robzach/cakeCity/frostingExtruderBlockDiagram.png

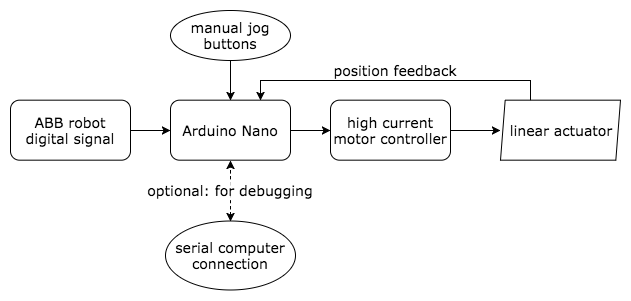
frostingExtruderBlockDiagram.png
