robzach/cakeCity/RobotPlateDesigns/robotPlateNEW.SLDASM

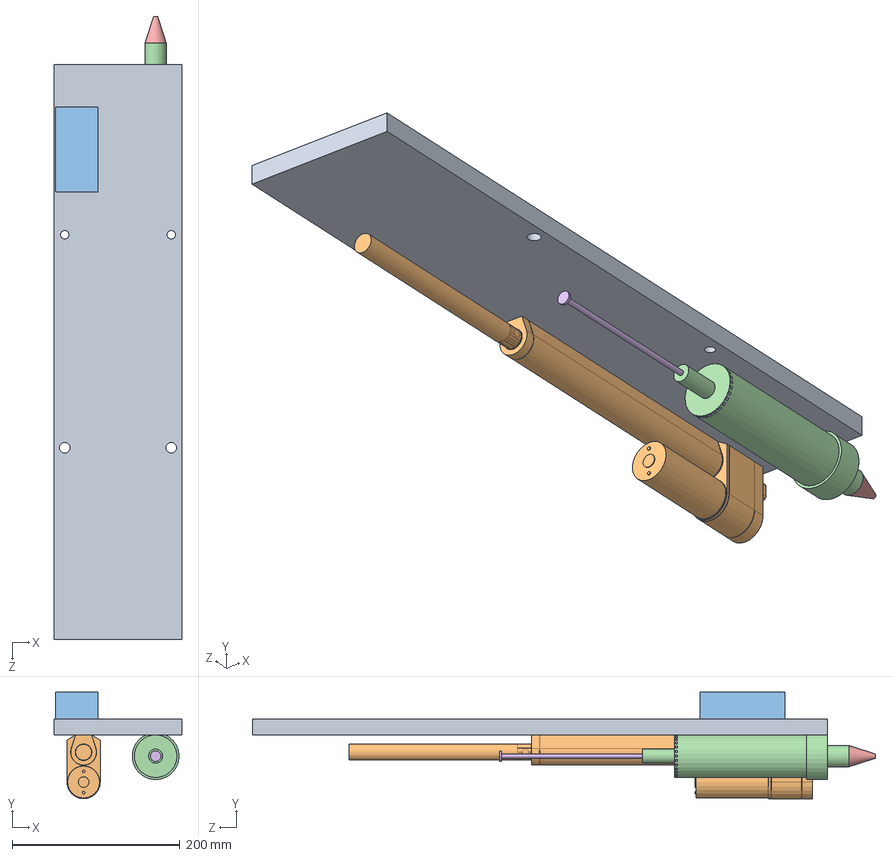
[picture p2: CAD file, 2017-04-19]
RobotPlateDesigns/robotPlateNEW.SLDASM
152.4 x 127.0 x 742.8 mm
backingPlate
linearActuator
PowerSupply
icingExtruderBody
icingTip
icingPlunger
