robzach/cakeCity/RobotPlateDesigns/robotPlate.SLDASM

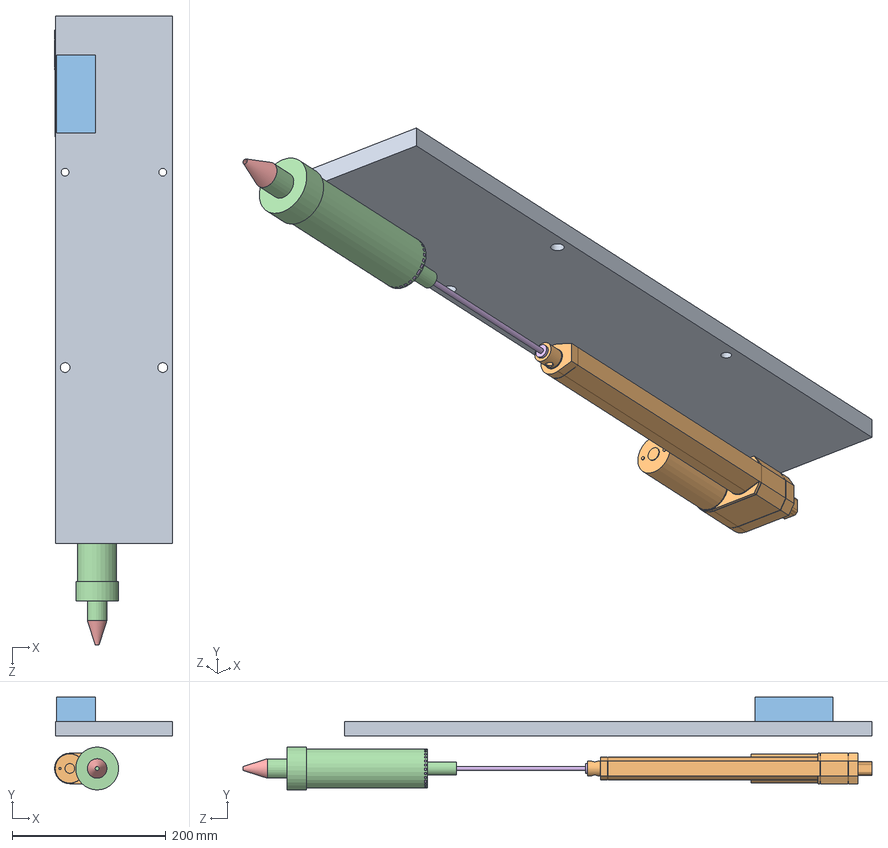
[picture p3: CAD file, 2017-04-19]
RobotPlateDesigns/robotPlate.SLDASM
153.5 x 120.9 x 818.1 mm
backingPlate
linearActuator
PowerSupply
icingExtruderBody
icingTip
icingPlunger
