robzach/cakeCity/RobotPlateDesigns/icingExtruder2.SLDASM

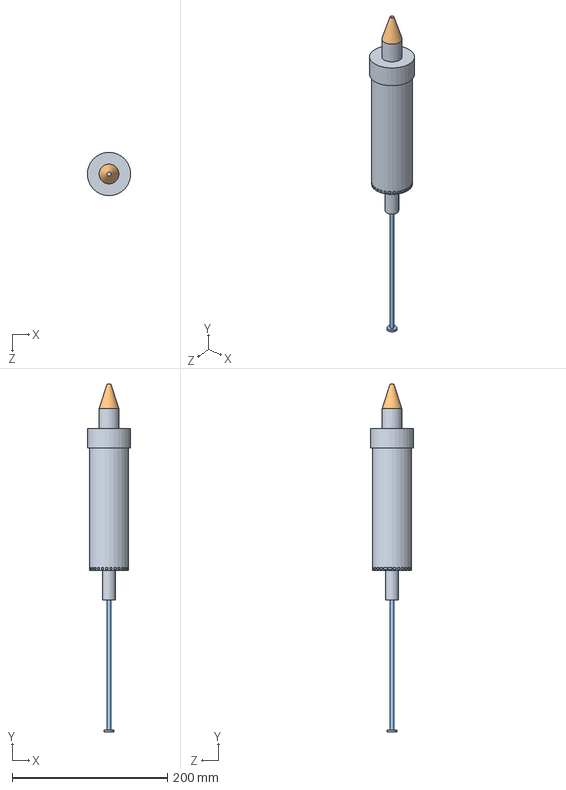
[picture p4: CAD file, 2017-04-19]
RobotPlateDesigns/icingExtruder2.SLDASM
55.6 x 448.2 x 55.9 mm
icingExtruderBody
icingTip
icingPlunger
