robzach/cakeCity/RobotPlateDesigns/linear_actuator_body_support.dxf

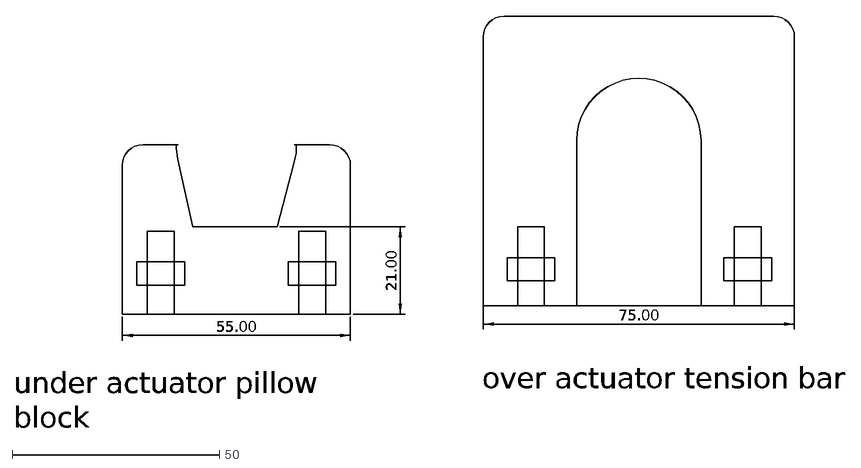
[picture p5: CAD file, 2017-05-11]
RobotPlateDesigns/linear_actuator_body_support.dxf
21.00
55.00
under actuator pillow block
75.00
over actuator tension bar
