robzach/cakeCity/RobotPlateDesigns/icing_press_support.dxf

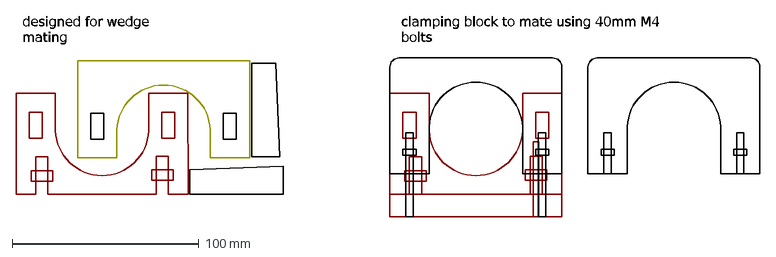
[picture p6: CAD file, 2017-05-11]
RobotPlateDesigns/icing_press_support.dxf
designed for wedge mating
clamping block to mate using 40mm M4 bolts
