robzach/cakeCity/RobotPlateDesigns/jog_button_mounting_plate.dxf

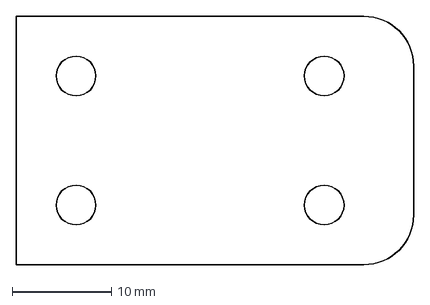
[picture p7: CAD file, 2017-05-10]
RobotPlateDesigns/jog_button_mounting_plate.dxf
40.0 x 25.0 mm
