robzach/cakeCity/RobotPlateDesigns/work_stand.dxf

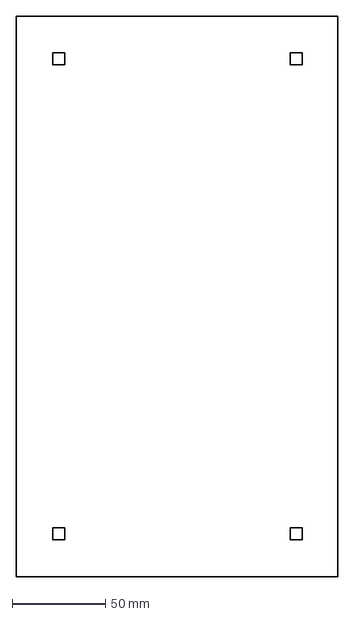
[picture p8: CAD file, 2017-04-26]
RobotPlateDesigns/work_stand.dxf
172.0 x 300.0 mm
