robzach/cakeCity/RobotPlateDesigns/backingPlate.SLDPRT

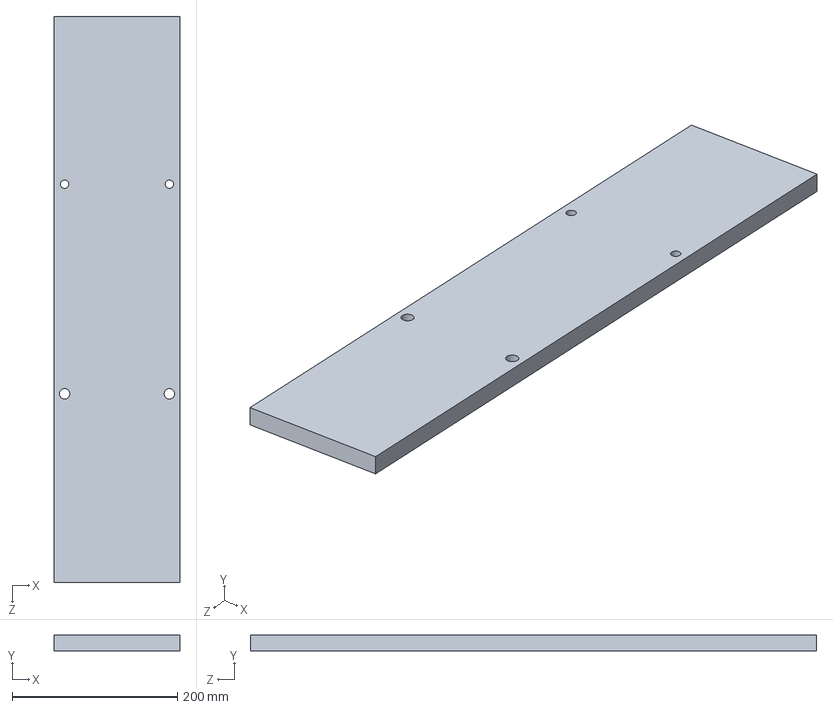
[picture p9: CAD file, 2017-04-19]
RobotPlateDesigns/backingPlate.SLDPRT
152.4 x 19.1 x 685.8 mm
