robzach/cakeCity/RobotPlateDesigns/linearActuator.SLDPRT

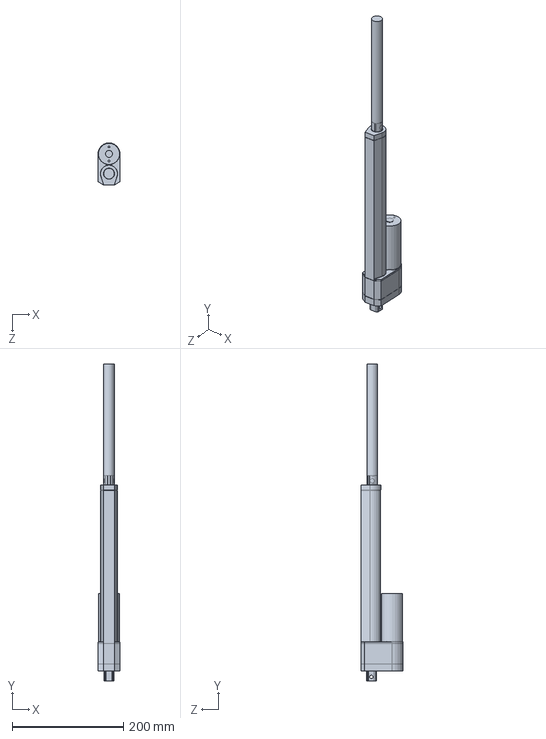
[picture p10: CAD file, 2017-04-19]
RobotPlateDesigns/linearActuator.SLDPRT
39.9 x 570.7 x 76.2 mm
