robzach/cakeCity/RobotPlateDesigns/icingPlunger.SLDPRT

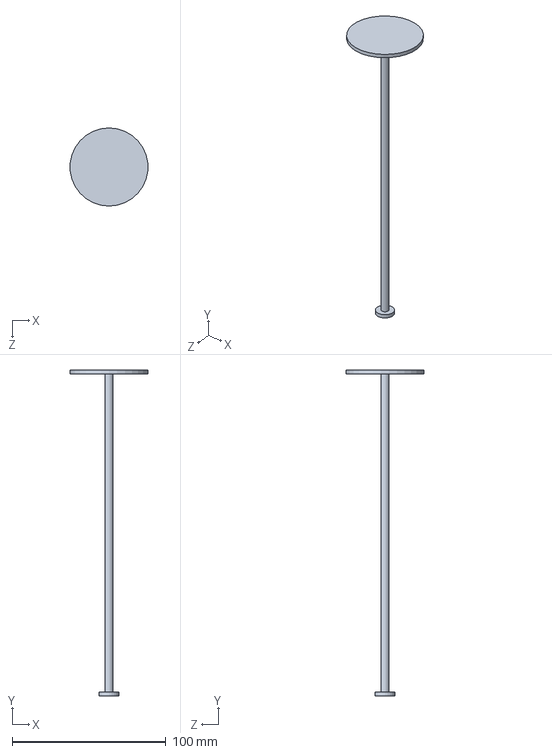
[picture p11: CAD file, 2017-04-19]
RobotPlateDesigns/icingPlunger.SLDPRT
50.5 x 212.1 x 50.8 mm
