robzach/cakeCity/RobotPlateDesigns/icingExtruderBody.SLDPRT

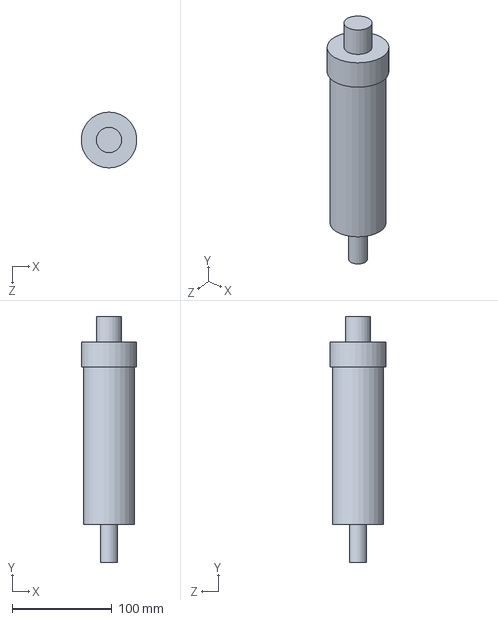
[picture p12: CAD file, 2017-04-19]
RobotPlateDesigns/icingExtruderBody.SLDPRT
55.6 x 246.4 x 55.9 mm
