robzach/cakeCity/RobotPlateDesigns/actuator_end_support.dxf

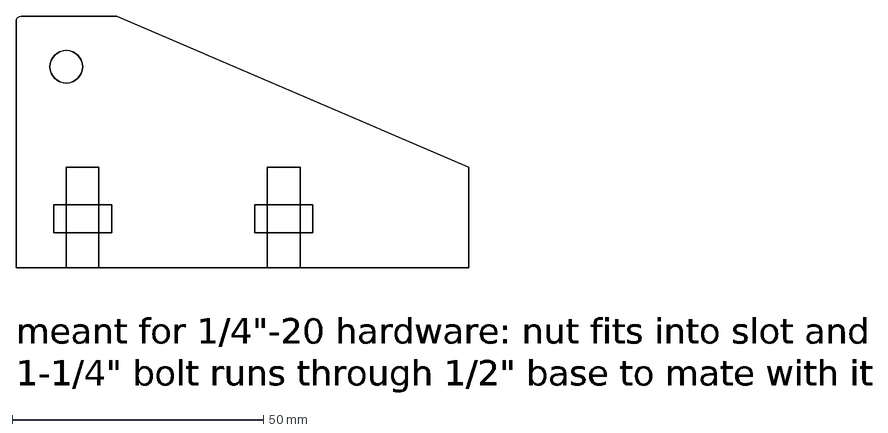
[picture p13: CAD file, 2017-04-19]
RobotPlateDesigns/actuator_end_support.dxf
meant for 1/4"-20 hardware: nut fits into slot and 1-1/4" bolt runs through 1/2" base to mate with it
