robzach/cakeCity/RobotPlateDesigns/linear_actuator_shaft_profile.DXF

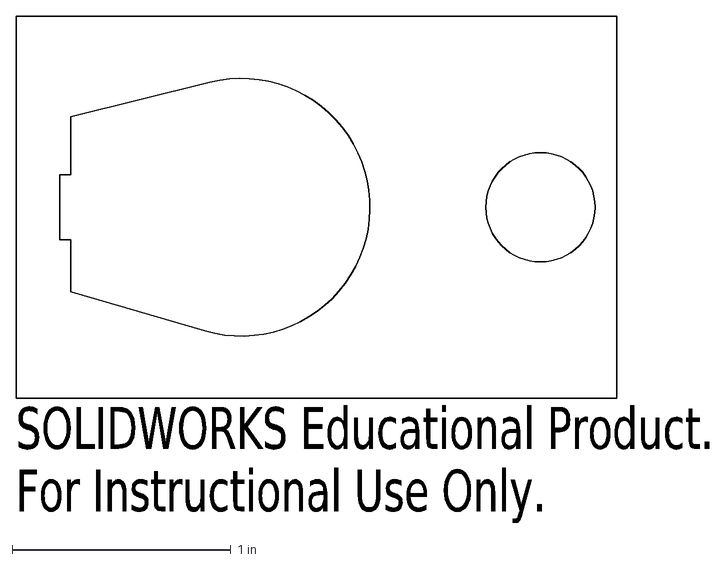
[picture p14: CAD file, 2017-04-18]
RobotPlateDesigns/linear_actuator_shaft_profile.DXF
SOLIDWORKS Educational Product.
For Instructional Use Only.
