robzach/cakeCity/RobotPlateDesigns/icingTip.SLDPRT

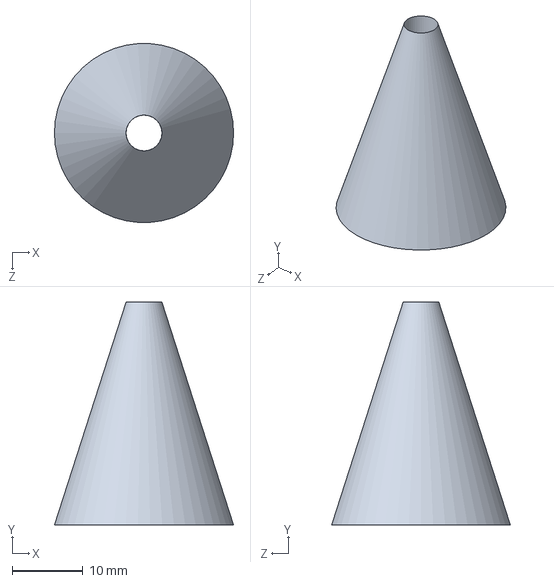
[picture p15: CAD file, 2017-04-17]
RobotPlateDesigns/icingTip.SLDPRT
25.4 x 31.6 x 25.3 mm
