robzach/cakeCity/RobotPlateDesigns/PowerSupply.SLDPRT

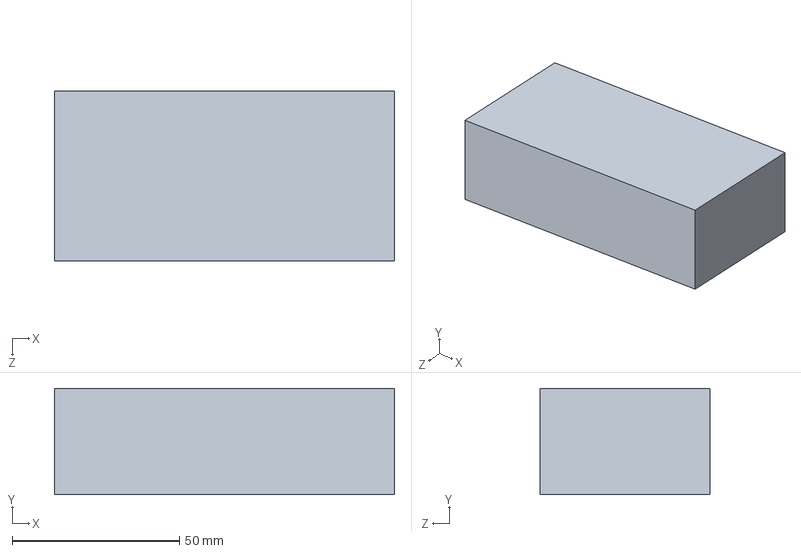
[picture p16: CAD file, 2017-04-17]
RobotPlateDesigns/PowerSupply.SLDPRT
101.6 x 31.8 x 50.8 mm
