robzach/cakeCity/RobotPlateDesigns/icingExtruder.SLDPRT

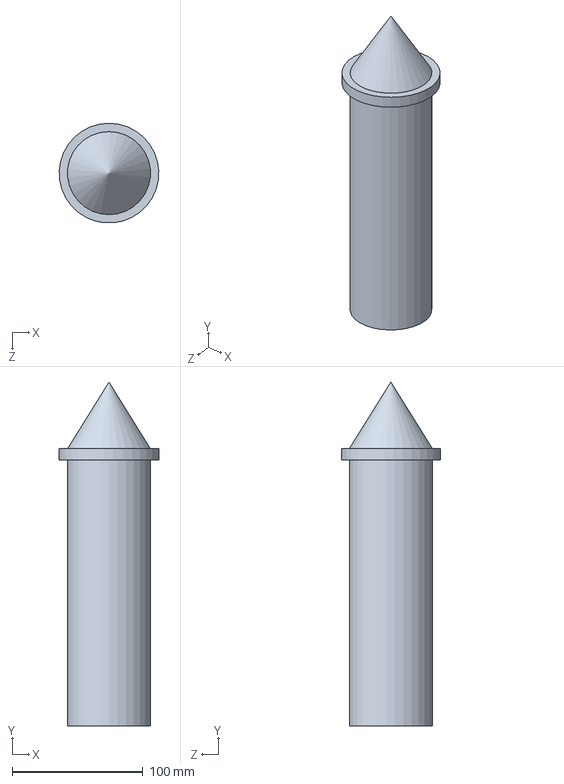
[picture p17: CAD file, 2017-04-03]
RobotPlateDesigns/icingExtruder.SLDPRT
76.1 x 262.9 x 76.0 mm
