robzach/cakeCity/(list of files, cad)

Other CAD files:
RobotPlateDesigns/robotPlateOLD.SLDASM
RobotPlateDesigns/backingPlate.SLDDRW
RobotPlateDesigns/backingPlate.dxf
