robzach/cakeCity/(list of files, drawings)

Other design files:
cakeExtruderSchematic.fzz
