robzach/cakeCity/Frigelli_FA_PO_wiring_diagram.jpg

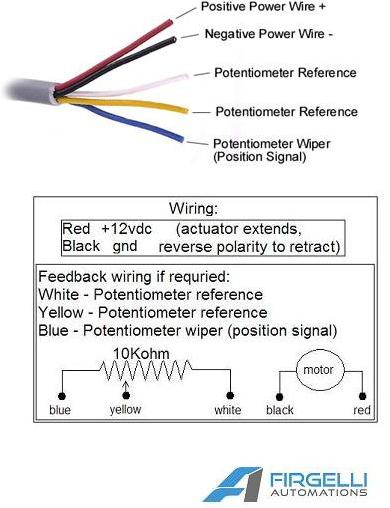
Frigelli_FA_PO_wiring_diagram.jpg
