robzach/cakeCity/(commit log)

2017-03-25 initial commitment
    [cakeExtruderSchematic.fzz]
2017-03-26 put the Arduino sketch in its own folder
2017-03-27 fixed dumb typos and inreased delay between transmitted pules
    [pulseIn_sender.ino]
2017-03-27 broke LED control into its own function
    [cakeExtruderControl.ino]
2017-03-28 motor takes only direction and on/off control; added jog buttons
2017-03-31 corrected voltage divider values
    [cakeExtruderSchematic.fzz]
2017-03-31 rewrote pulseIn to use interrupt and port access; added results of old pulseIn testing; updated schematic
    [cakeExtruderSchematic.fzz]
2017-04-03 added plate designs
    [PowerSupply.SLDPRT, backingPlate.SLDPRT, icingExtruder.SLDPRT, linearActuator.SLDPRT, robotPlate.SLDASM]
2017-04-09 added manufacturers' diagrams, added a simple bang-bang feedback motor driver though it didn't work
    [motor_pos_from_serial_command.ino, pulseIn_sender.ino]
2017-04-10 added proportional motor control; added backing plate PDF
2017-04-17 added speed control to sketch though it doesn't work properly yet
    [motor_pos_from_serial_command.ino]
2017-04-17 updated design
    [#actuator_end_support.dxf, PowerSupply.SLDPRT, actuator_end_support.dxf, backingPlate.SLDDRW, backingPlate.SLDPRT, icingExtruder2.SLDASM, icingExtruderBody.SLDPRT, icingPlunger.SLDPRT]
2017-04-17 added actuator_end_support to mate with far end of linear actuator
    [actuator_end_support.dxf]
2017-04-18 added linear actuator shaft profile, kindly donated by Roberto A.
    [linear_actuator_shaft_profile.DXF]
2017-04-19 added updated icing press support designed for lasercutting out of 1/4" material
    [icing_press_support.dxf]
2017-04-19 revision 2 of actuator end support with sizing for 1/4"-20 nut and bolt
    [actuator_end_support.dxf]
2017-04-19 updated bolt holder for icing press support
    [icing_press_support.dxf]
2017-04-19 updated icing press support
    [icing_press_support.dxf]
2017-04-19 added backing plate in pure DXF form
    [backingPlate.dxf]
2017-04-19 fixed icing press support top mating part's hole positions
    [icing_press_support.dxf]
2017-04-19 moved actuator end mount holes to their empirically correct positions
    [backingPlate.dxf]
2017-04-19 simplified motorMoveSpeed to simple event loop
2017-04-19 multiple modifications, including rotating the icing press by 180º
    [#actuator_end_support.dxf, backingPlate.SLDPRT, icingExtruder2.SLDASM, icingExtruderBody.SLDPRT, icingPlunger.SLDPRT, linearActuator.SLDPRT, robotPlate.SLDASM, robotPlateNEW.SLDASM]
2017-04-19 added linear actuator body support
    [linear_actuator_body_support.dxf]
2017-04-19 lengthened legs of top clamping part
    [linear_actuator_body_support.dxf]
2017-04-19 slightly tightened up pillow block width
    [linear_actuator_body_support.dxf]
2017-04-19 adjusted backing plate to accommodate all mount points for linear actuator and icing press
    [backingPlate.dxf]
2017-04-26 added work stand for supporting plate lifted off of a tabletop
    [work_stand.dxf]
2017-04-26 work stand file didn't work properly last time; lightly modified, resaved, trying again
    [work_stand.dxf]
2017-04-28 added PWM-based speed control; added serial debugging; started non-PWM speed control but it's not working properly yet
    [pulseIn_receiver.ino]
2017-04-28 changed pin assignments to match board wiring
2017-04-28 changed expected pulse widths; change motor pin assignments; added PWM pin though didn't implement it
    [cakeExtruderControl.ino]
2017-04-29 attempted to add velocity-based drive option but it is inconsistent and seems to make a heavy current demand on the power supply, which is part of the inconsistency
2017-05-01 updated to retract slowly, based on motor_pos_from_serial_command sketch template; added support for jog buttons though it is untested in hardware as of yet
2017-05-08 added position-based retract upon switching from mode 1 to 0 to stop lots of extra spring-loaded icing from coming out after extruding
2017-05-10 added jog_button_mounting_plate.dxf
    [jog_button_mounting_plate.dxf]
2017-05-10 updated icing press support to include model for clamping the top with M4 nuts and bolts rather than wedges
    [icing_press_support.dxf]
2017-05-11 added clamping piece with attachment to bottom of backing plate, rather than wedge lock
    [icing_press_support.dxf]
2017-05-11 added frosting extruder block diagram
2017-05-11 small modifications
    [backingPlate.dxf, linear_actuator_body_support.dxf]
